IGMercier/Autonomous-Prospecting-and-Extraction-Systems-Controls/encoder_schematic.pdf

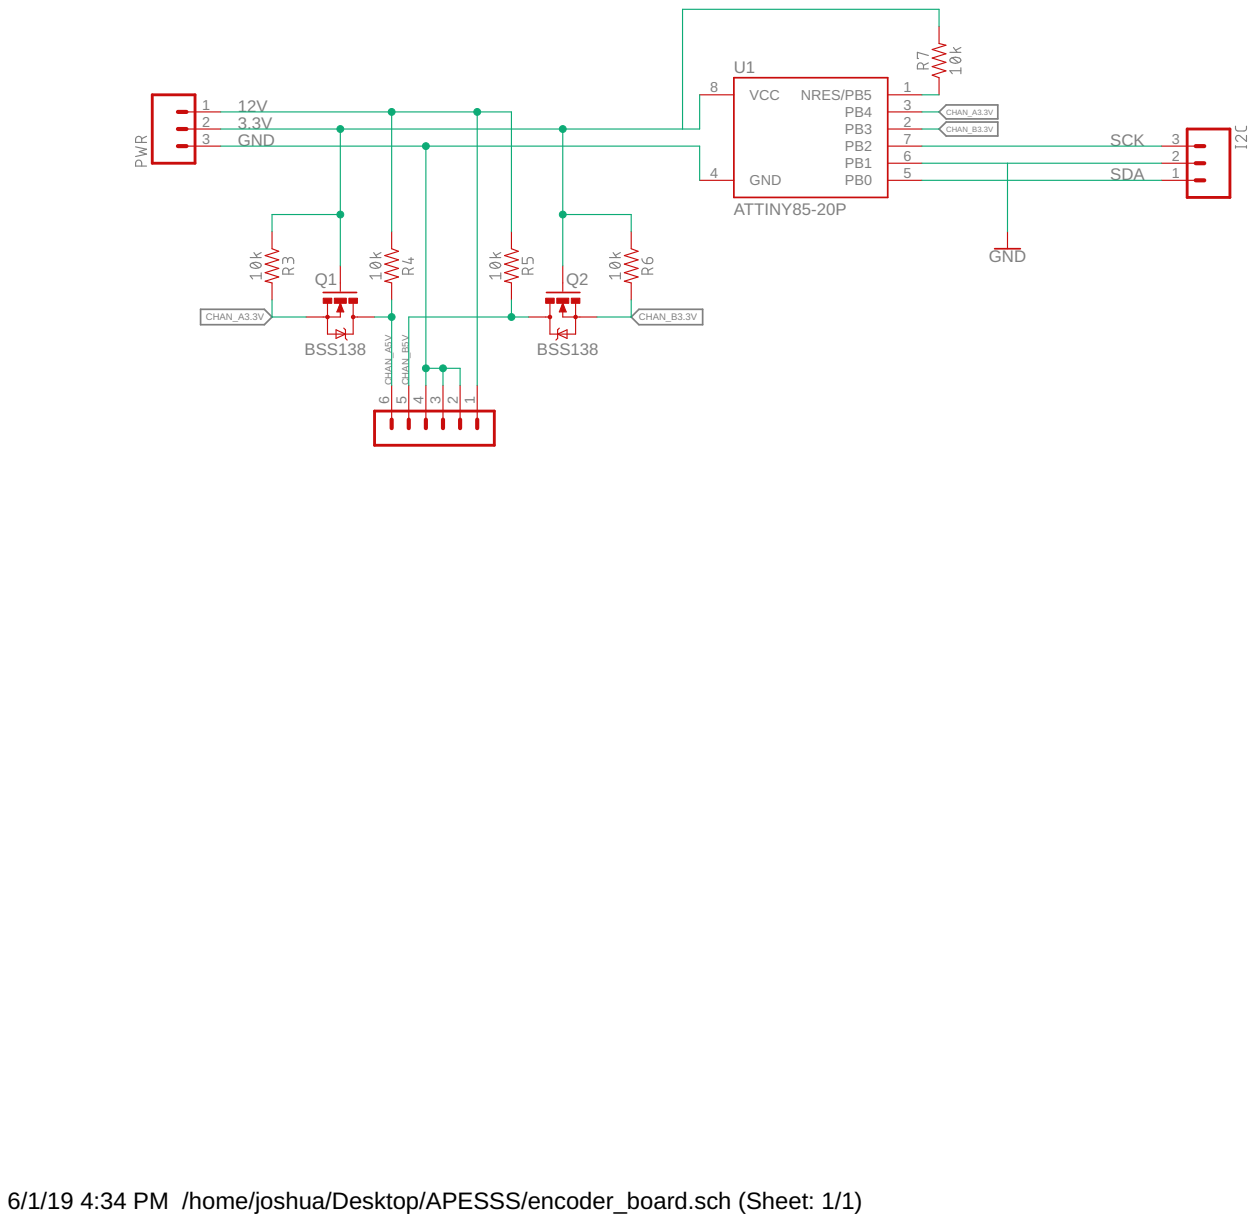
[picture p1: page 1]

6/1/19 4:34 PM /home/joshua/Desktop/APESSS/encoder_board.sch (Sheet: 1/1)
