IGMercier/Autonomous-Prospecting-and-Extraction-Systems-Controls/encoder_board.pdf

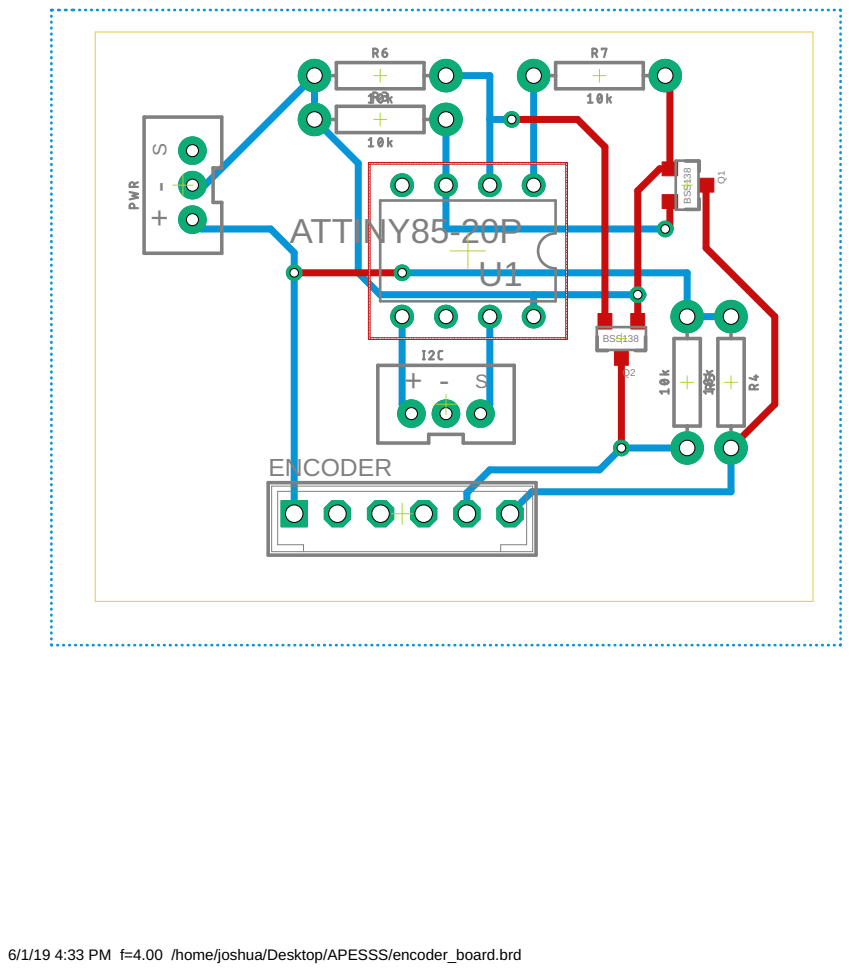
[picture p2: page 1]

6/1/19 4:33 PM f=4.00 /home/joshua/Desktop/APESSS/encoder_board.brd
