IGMercier/Autonomous-Prospecting-and-Extraction-Systems-Controls/single_board_controller.pdf

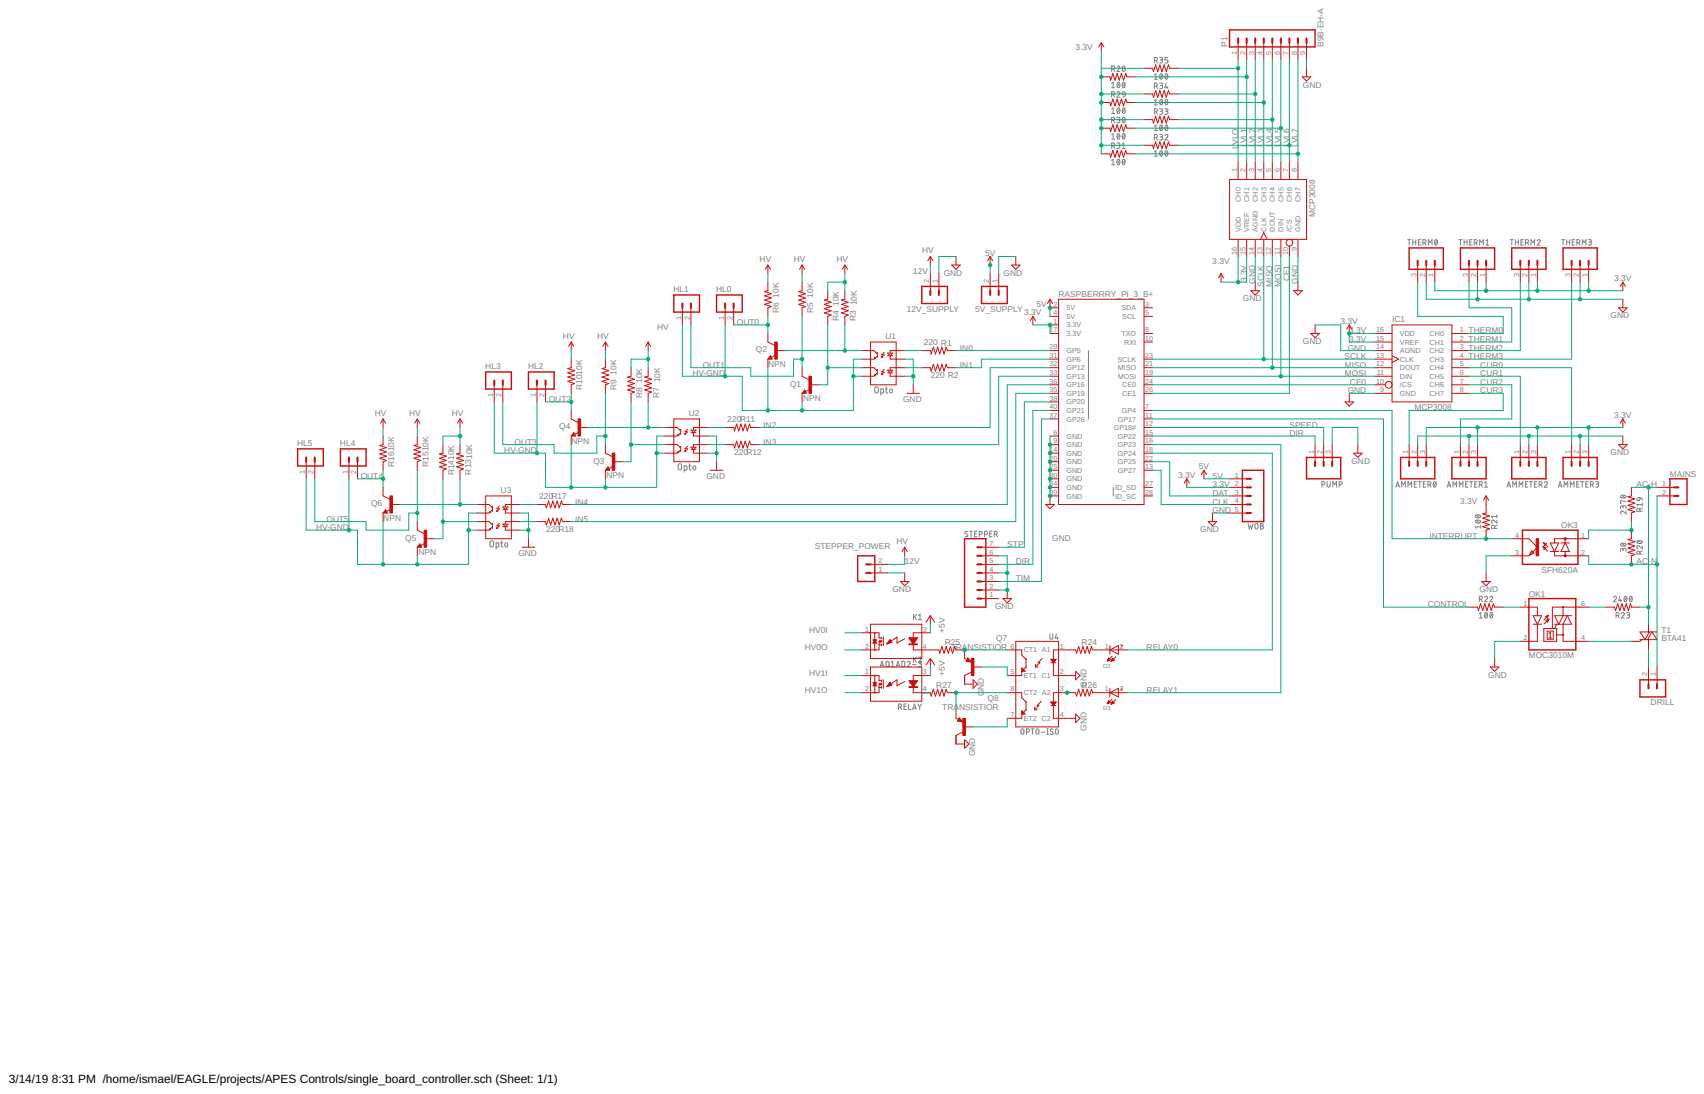
[picture p3: page 1]

24 | CE0 10 | 7 CH7 CUR2

GND 9 | CUR3

3/14/19 8:31 PM /home/ismael/EAGLE/projects/APES Controls/single_board_controller.sch (Sheet: 1/1)
