IGMercier/Autonomous-Prospecting-and-Extraction-Systems-Controls/drill_controller.pdf

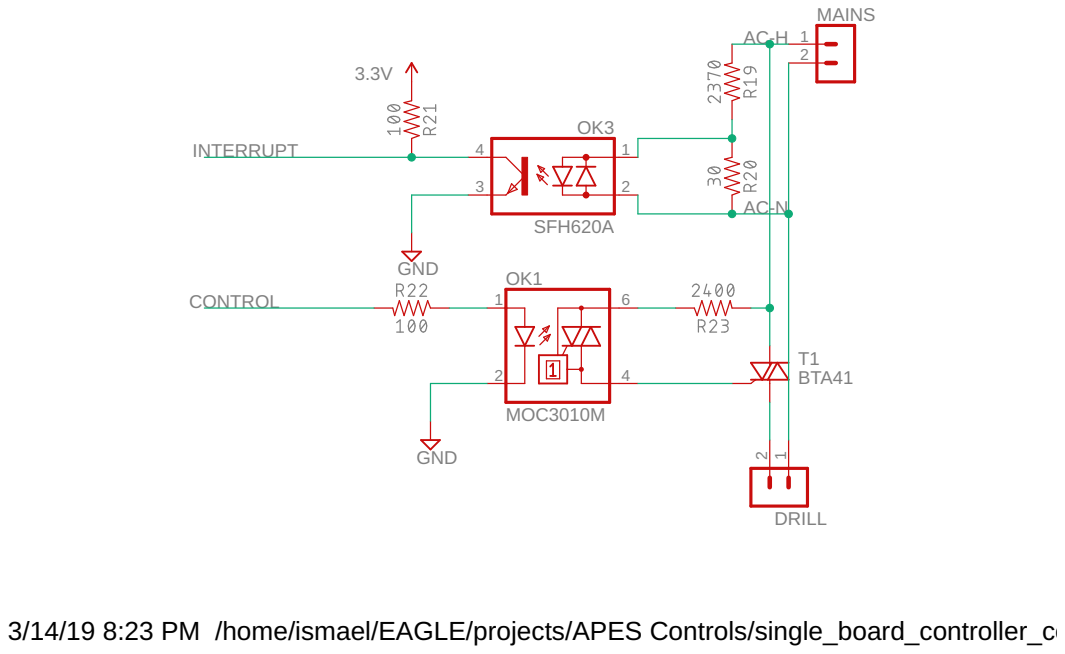
[picture p4: page 1]

3/14/19 8:23 PM /home/ismael/EAGLE/projects/APES Controls/single_board_controller_copy.sch (Sheet: 1/1)
