IGMercier/Autonomous-Prospecting-and-Extraction-Systems-Controls/heater_driver.pdf

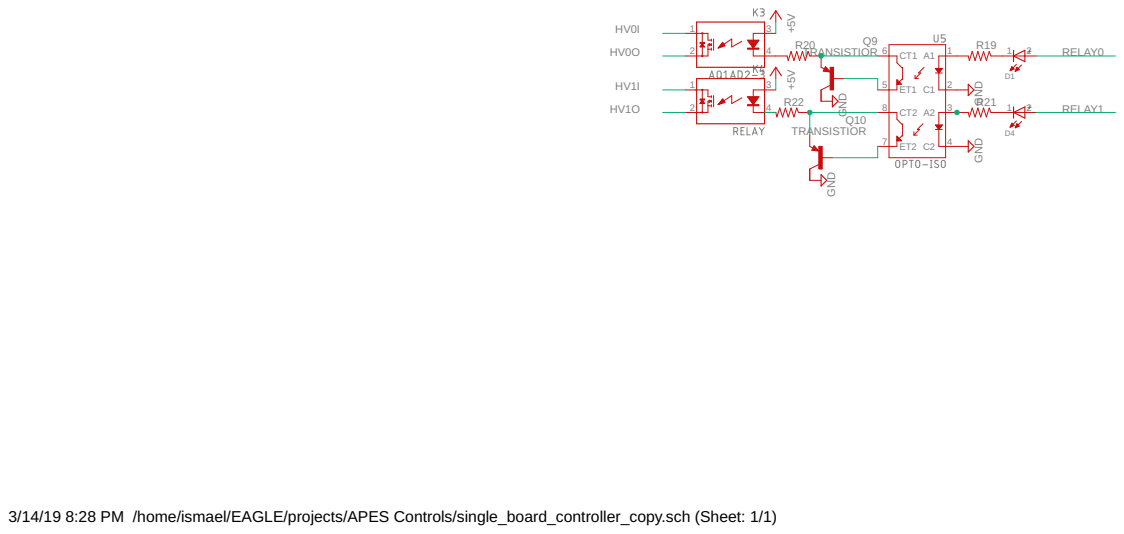
[picture p5: page 1]

3/14/19 8:28 PM /home/ismael/EAGLE/projects/APES Controls/single_board_controller_copy.sch (Sheet: 1/1)
