IGMercier/Autonomous-Prospecting-and-Extraction-Systems-Controls/temp_curr_sense.pdf

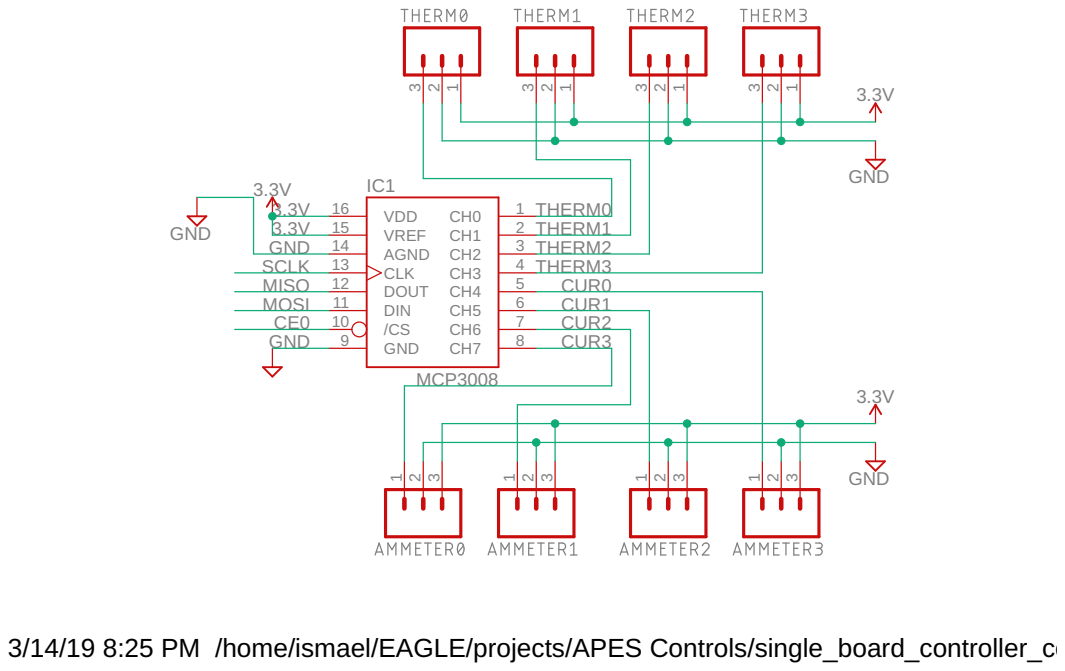
[picture p6: page 1]

3/14/19 8:25 PM /home/ismael/EAGLE/projects/APES Controls/single_board_controller_copy.sch (Sheet: 1/1)
