IGMercier/Autonomous-Prospecting-and-Extraction-Systems-Controls/valve_small_heater.pdf

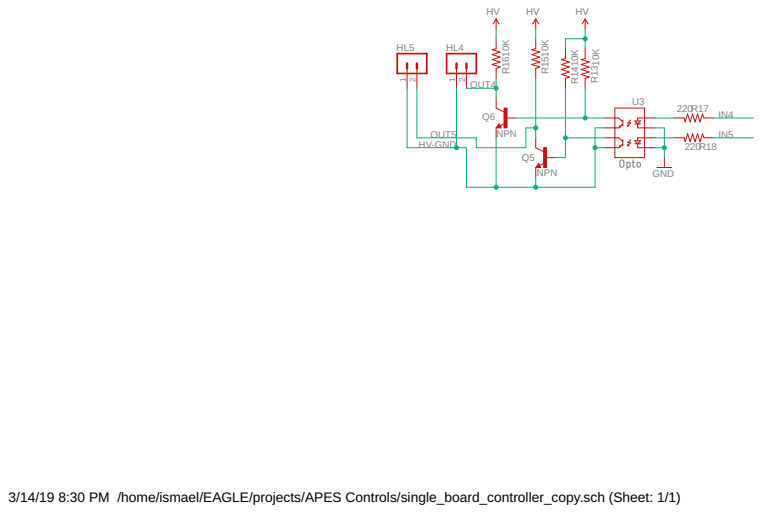
[picture p7: page 1]

3/14/19 8:30 PM /home/ismael/EAGLE/projects/APES Controls/single_board_controller_copy.sch (Sheet: 1/1)
