IGMercier/Autonomous-Prospecting-and-Extraction-Systems-Controls/water_level.pdf

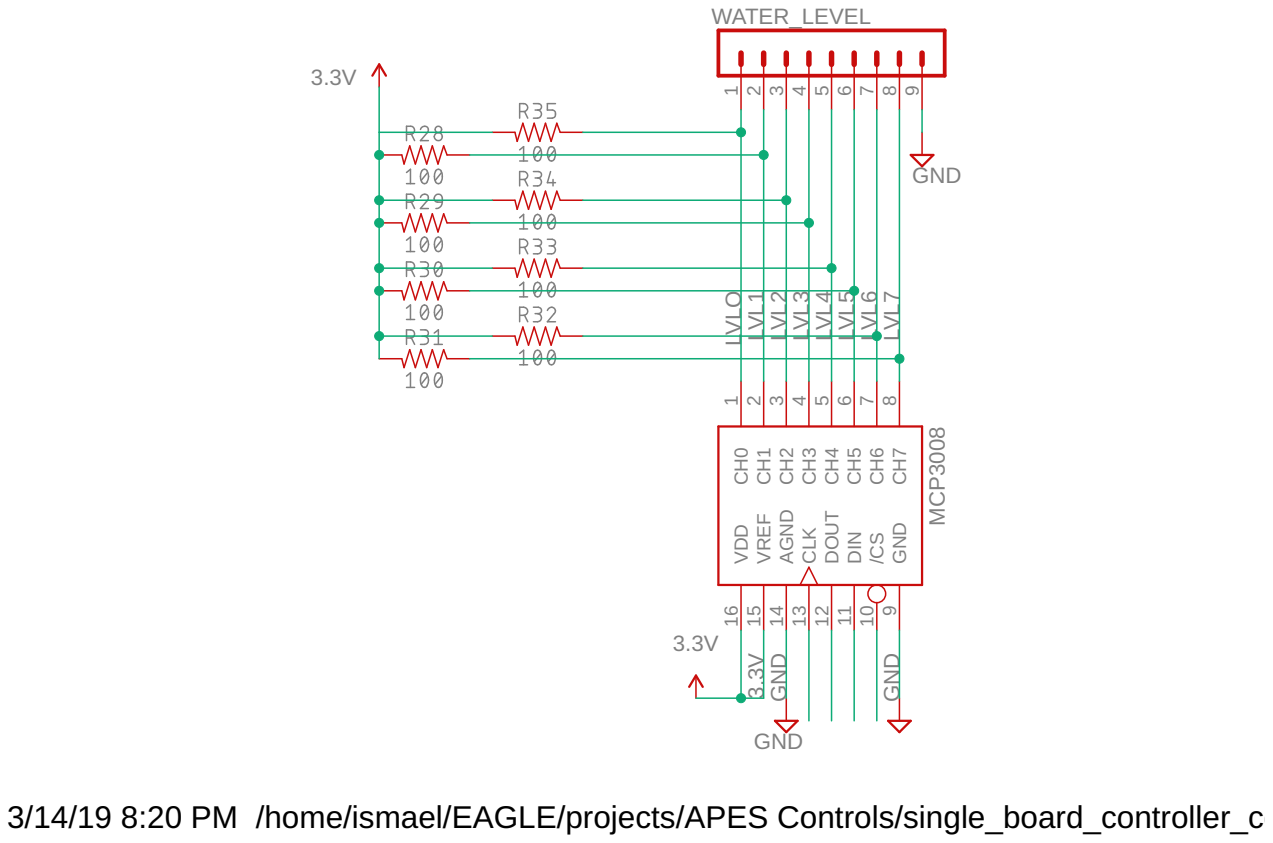
[picture p8: page 1]

3/14/19 8:20 PM /home/ismael/EAGLE/projects/APES Controls/single_board_controller_copy.sch (Sheet: 1/1)
