IGMercier/Autonomous-Prospecting-and-Extraction-Systems-Controls/single_board_controller.brd

## EAGLE design single_board_controller.brd (2019-06-02)

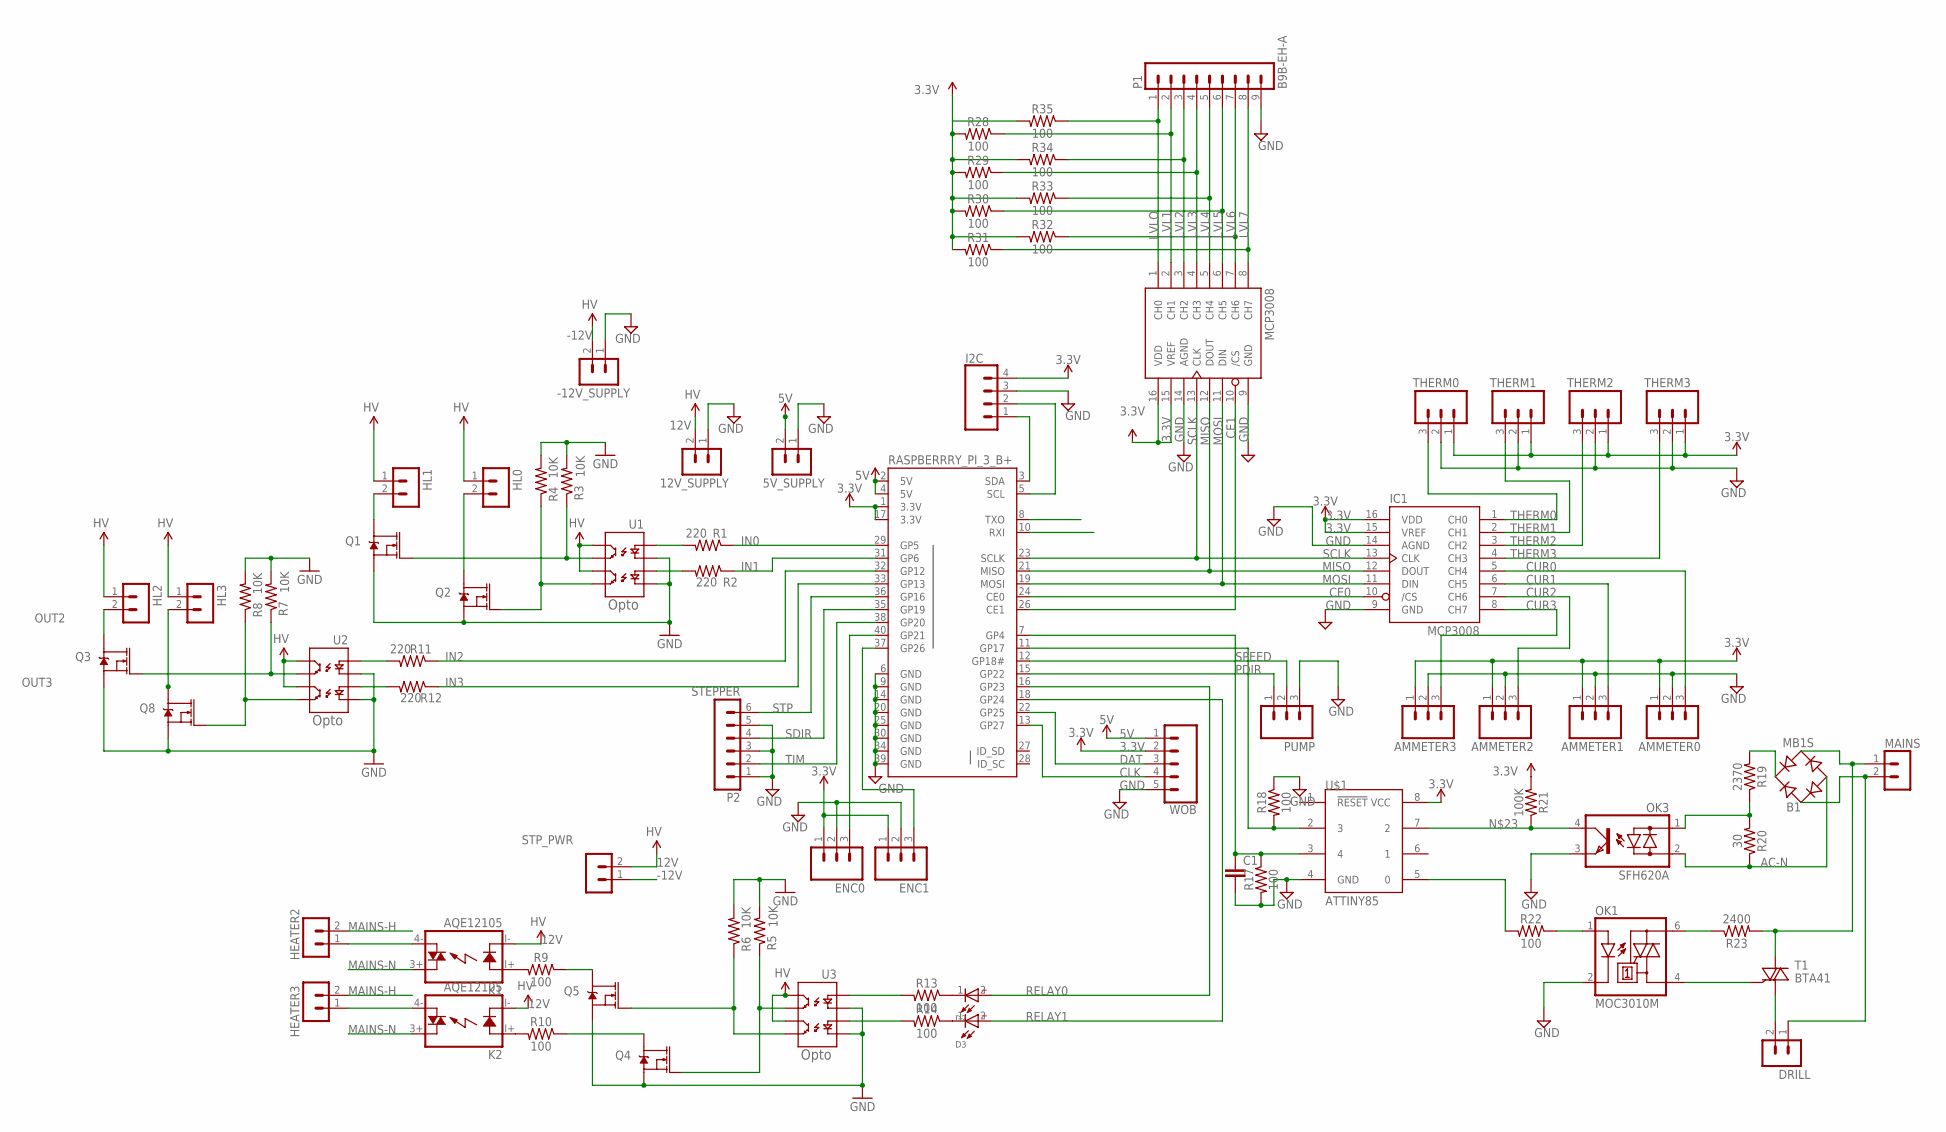
[picture p9: schematic single_board_controller.sch]

Parts:
5V_SUPPLY, 12V_SUPPLY: B2P-VH
-12V_SUPPLY: B2P-VH
AMMETER0, AMMETER1, AMMETER2, AMMETER3: CONN_03JST-PTH-VERT; JST-3-PTH-VERT
B1: MB1S; SOIC-4
C1: C; C0805
D2, D3: WL-SMRW_1206_156120YS75000-Y; WL-SMRW-1206-RECT
DRILL: B2P-VH
ENC0, ENC1: CONN_03JST-PTH-VERT; JST-3-PTH-VERT
HEATER2, HEATER3: B2P-VH
HL0, HL1, HL2, HL3: B2P-VH
I2C: CONN_04JST-PTH-VERT; JST-4-PTH-VERT
IC1, IC2: MCP3008; DIL16
K1, K2: AQE12105; AQE
MAINS: B2P-VH
OK1: MOC3010M; DIL06
OK3: SFH620A; DIL04
P1: B9B-EH-A
P2: STEPPER; B6B-EH-A
PUMP: CONN_03JST-PTH-VERT; JST-3-PTH-VERT
Q1, Q2, Q3, Q4, Q5, Q8: 35A/25V/8.5mΩ; DPAK
R1, R2, R11, R12: 220; 0603-RES
R3, R4, R5, R6, R7, R8: 10K; 0603-RES
R9, R10, R13, R14, R17, R18, R22, R28, R29, R30, R31, R32, R33, R34, R35: 100; 0805
R19: 2370; 0805
R20: 30; 0805
R21: 100K; 0805
R23: 2400; 0805
RASPBERRRY_PI_3_B+: RASPBERRYPI-40-PIN-GPIO_PTH_NO_SHROUD; 2X20
STP_PWR: B2P-VH
T1: BTA41; TOP3S-1
THERM0, THERM1, THERM2, THERM3: CONN_03JST-PTH-VERT; JST-3-PTH-VERT
U1, U2, U3: OPTOISOLATOR-2SOIC8; SO08-2
U$1: ATTINY85; 8P3
WOB: CONN_05JST-VERT; JST-5-PTH-VERT

Connections:
3.3V: AMMETER0.1, AMMETER1.1, AMMETER2.1, AMMETER3.1, ENC0.1, ENC1.1, I2C.4, IC1.15 (VREF), IC1.16 (VDD), IC2.15 (VREF), IC2.16 (VDD), R21.2, R28.2, R29.2, R30.2, R31.2, R32.2, R33.2, R34.2, R35.2, RASPBERRRY_PI_3_B+.1 (3.3V), RASPBERRRY_PI_3_B+.17 (3.3V), THERM0.1, THERM1.1, THERM2.1, THERM3.1, U$1.8 (VCC), WOB.2
5V: 5V_SUPPLY.2, RASPBERRRY_PI_3_B+.2 (5V), RASPBERRRY_PI_3_B+.4 (5V), WOB.1
12V: 12V_SUPPLY.2, HL0.1, HL1.1, HL2.1, HL3.1, K1.I- (K), K2.I- (K), STP_PWR.2, U1.6 (CL2), U1.8 (CL1), U2.6 (CL2), U2.8 (CL1), U3.6 (CL2), U3.8 (CL1)
-12V: -12V_SUPPLY.2, STP_PWR.1
AC-N: B1.-, OK3.2 (AC2), R20.1
CE0: IC1.10 (/CS), RASPBERRRY_PI_3_B+.24 (CE0)
CE1: IC2.10 (/CS), RASPBERRRY_PI_3_B+.26 (CE1)
CLK: RASPBERRRY_PI_3_B+.13 (GP27), WOB.4
CONTROL: R18.2, RASPBERRRY_PI_3_B+.11 (GP17), U$1.2 (3)
CUR0: AMMETER0.3, IC1.5 (CH4)
CUR1: AMMETER1.3, IC1.6 (CH5)
CUR2: AMMETER2.3, IC1.7 (CH6)
CUR3: AMMETER3.3, IC1.8 (CH7)
DAT: RASPBERRRY_PI_3_B+.22 (GP25), WOB.3
GND: 5V_SUPPLY.1, 12V_SUPPLY.1, -12V_SUPPLY.1, AMMETER0.2, AMMETER1.2, AMMETER2.2, AMMETER3.2, C1.2, ENC0.2, ENC1.2, I2C.3, IC1.9 (GND), IC1.14 (AGND), IC2.9 (GND), IC2.14 (AGND), OK1.2 (C), OK3.3 (E), P1.9, P2.1, P2.3, P2.5, PUMP.3, Q1.3 (S), Q2.3 (S), Q3.3 (S), Q4.3 (S), Q5.3 (S), Q8.3 (S), R3.2, R4.2, R5.2, R6.2, R7.2, R8.2, R17.2, R18.1, RASPBERRRY_PI_3_B+.6 (GND), RASPBERRRY_PI_3_B+.9 (GND), RASPBERRRY_PI_3_B+.14 (GND), RASPBERRRY_PI_3_B+.20 (GND), RASPBERRRY_PI_3_B+.25 (GND), RASPBERRRY_PI_3_B+.30 (GND), RASPBERRRY_PI_3_B+.34 (GND), RASPBERRRY_PI_3_B+.39 (GND), THERM0.2, THERM1.2, THERM2.2, THERM3.2, U1.2 (C1), U1.4 (C2), U2.2 (C1), U2.4 (C2), U3.2 (C1), U3.4 (C2), U$1.4 (GND), WOB.5
IN0: R1.1, RASPBERRRY_PI_3_B+.29 (GP5)
IN1: R2.1, RASPBERRRY_PI_3_B+.31 (GP6)
IN2: R11.1, RASPBERRRY_PI_3_B+.32 (GP12)
IN3: R12.1, RASPBERRRY_PI_3_B+.33 (GP13)
LVL1: IC2.2 (CH1), P1.2, R28.1
LVL2: IC2.3 (CH2), P1.3, R34.1
LVL3: IC2.4 (CH3), P1.4, R29.1
LVL4: IC2.5 (CH4), P1.5, R33.1
LVL5: IC2.6 (CH5), P1.6, R30.1
LVL6: IC2.7 (CH6), P1.7, R32.1
LVL7: IC2.8 (CH7), P1.8, R31.1
LVLO: IC2.1 (CH0), P1.1, R35.1
MAINS-H: B1.~2 (AC2), HEATER2.2, HEATER3.2, MAINS.1, R23.2, T1.A2
MAINS-N: B1.~1 (AC1), DRILL.1, K1.3+ (DS1), K2.3+ (DS1), MAINS.2
MISO: IC1.12 (DOUT), IC2.12 (DOUT), RASPBERRRY_PI_3_B+.21 (MISO)
MOSI: IC1.11 (DIN), IC2.11 (DIN), RASPBERRRY_PI_3_B+.19 (MOSI)
unnamed: R1.2, U1.1 (A1)
unnamed: R2.2, U1.3 (A2)
unnamed: R11.2, U2.1 (A1)
unnamed: R12.2, U2.3 (A2)
unnamed: ENC1.3, RASPBERRRY_PI_3_B+.37 (GP26)
unnamed: ENC0.3, RASPBERRRY_PI_3_B+.40 (GP21)
unnamed: OK3.1 (AC1), R19.1, R20.2
unnamed: OK1.1 (A), R22.1
unnamed: OK1.6 (A2), R23.1
unnamed: OK1.4 (A1), T1.G
unnamed: DRILL.2, T1.A1
unnamed: HEATER2.1, K1.4- (DS2)
unnamed: D2.1 (-), R13.1
unnamed: K2.I+ (A), R10.2
unnamed: D3.1 (-), R14.1
unnamed: K1.I+ (A), R9.2
unnamed: HEATER3.1, K2.4- (DS2)
unnamed: R13.2, U3.1 (A1)
unnamed: OK3.4 (C), R21.1, U$1.7 (2)
unnamed: B1.+, R19.2
unnamed: R22.2, U$1.5 (0)
unnamed: I2C.2, RASPBERRRY_PI_3_B+.5 (SCL)
unnamed: C1.1, R17.1, RASPBERRRY_PI_3_B+.7 (GP4), U$1.3 (4)
unnamed: I2C.1, RASPBERRRY_PI_3_B+.3 (SDA)
unnamed: R14.2, U3.3 (A2)
unnamed: Q5.4 (D), R9.1
unnamed: Q4.4 (D), R10.1
OUT0: HL1.2, Q1.4 (D)
OUT1: HL0.2, Q2.4 (D)
OUT1N: Q1.1 (G), R3.1, U1.7 (EM1)
OUT1N1: Q3.1 (G), R7.1, U2.7 (EM1)
OUT1N2: Q4.1 (G), R5.1, U3.7 (EM1)
OUT2: HL2.2, Q3.4 (D)
OUT2N: Q2.1 (G), R4.1, U1.5 (EM2)
OUT2N1: Q8.1 (G), R8.1, U2.5 (EM2)
OUT2N2: Q5.1 (G), R6.1, U3.5 (EM2)
OUT3: HL3.2, Q8.4 (D)
PDIR: PUMP.1, RASPBERRRY_PI_3_B+.15 (GP22)
RELAY0: D2.2 (+), RASPBERRRY_PI_3_B+.16 (GP23)
RELAY1: D3.2 (+), RASPBERRRY_PI_3_B+.18 (GP24)
SCLK: IC1.13 (CLK), IC2.13 (CLK), RASPBERRRY_PI_3_B+.23 (SCLK)
SDIR: P2.4, RASPBERRRY_PI_3_B+.35 (GP19)
SPEED: PUMP.2, RASPBERRRY_PI_3_B+.12 (GP18#)
STP: P2.6, RASPBERRRY_PI_3_B+.36 (GP16)
THERM0: IC1.1 (CH0), THERM0.3
THERM1: IC1.2 (CH1), THERM1.3
THERM2: IC1.3 (CH2), THERM2.3
THERM3: IC1.4 (CH3), THERM3.3
TIM: P2.2, RASPBERRRY_PI_3_B+.38 (GP20)

Notes on the sheet:
Opto

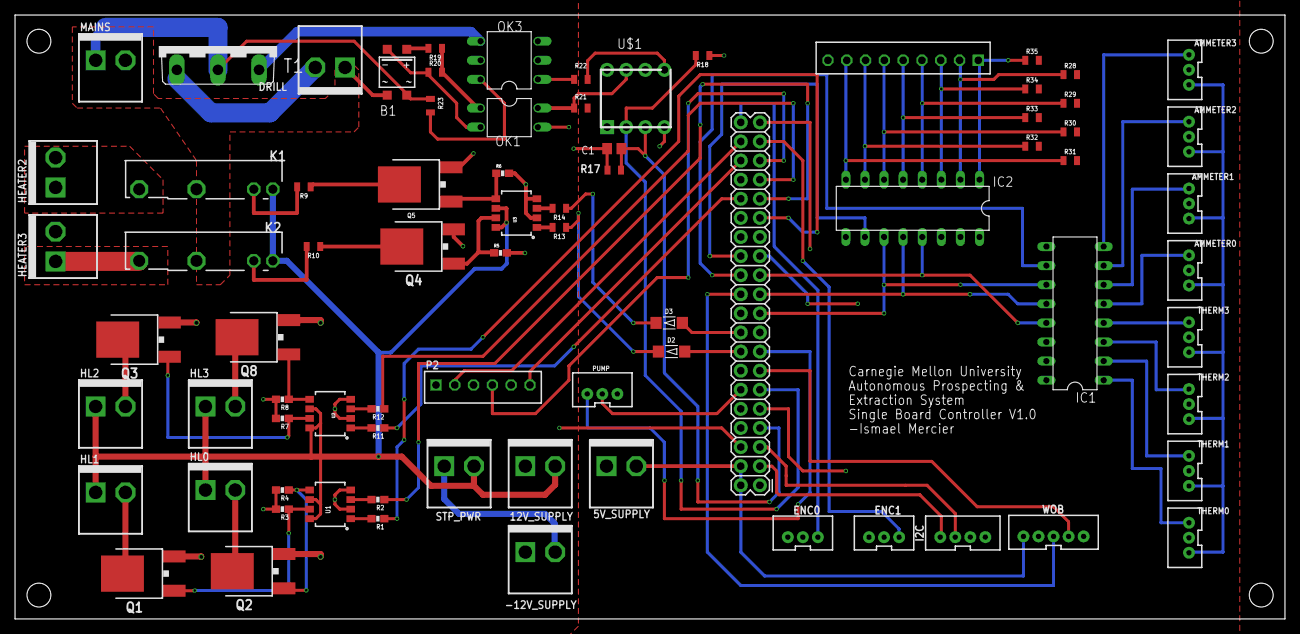
[picture p10: board single_board_controller.brd from above]

Board: 2 copper layers, 168.9 x 80.3 mm, 78 parts (0 on the bottom side), 80 nets.
