IGMercier/Autonomous-Prospecting-and-Extraction-Systems-Controls/encoder_board.brd

## EAGLE design encoder_board.brd (2019-04-23)

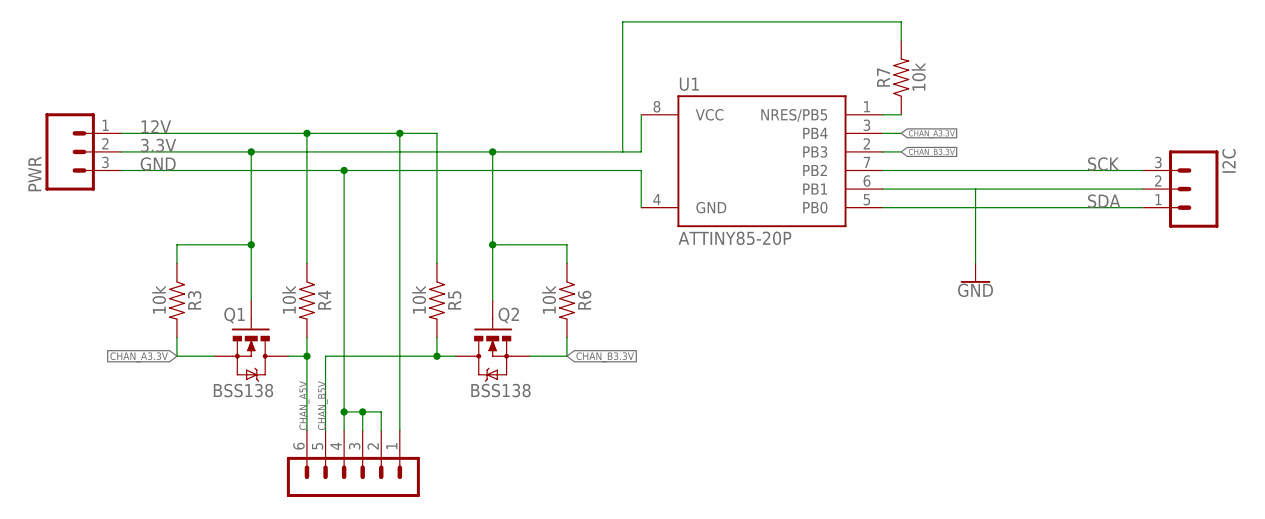
[picture p11: schematic encoder_board.sch]

Parts:
ENCODER: B6B-EH-A
I2C: CONN_03JST-PTH-VERT; JST-3-PTH-VERT
PWR: CONN_03JST-PTH-VERT; JST-3-PTH-VERT
Q1, Q2: BSS138; SOT23-3
R3, R4, R5, R6, R7: 10k; AXIAL-0.3
U1: ATTINY85-20P; PDIP08_300MIL

Connections:
3.3V: PWR.2, Q1.1 (G), Q2.1 (G), R3.P$1 (1), R6.P$1 (1), R7.P$2 (2), U1.8 (VCC)
12V: ENCODER.1, PWR.1, R4.P$1 (1), R5.P$1 (1)
CHAN_A3.3V: Q1.2 (S), R3.P$2 (2), U1.3 (PB4)
CHAN_A5V: ENCODER.6, Q1.3 (D), R4.P$2 (2)
CHAN_B3.3V: Q2.2 (S), R6.P$2 (2), U1.2 (PB3)
CHAN_B5V: ENCODER.5, Q2.3 (D), R5.P$2 (2)
GND: ENCODER.2, ENCODER.3, ENCODER.4, I2C.2, PWR.3, U1.4 (GND), U1.6 (PB1)
unnamed: R7.P$1 (1), U1.1 (NRES/PB5)
SCK: I2C.3, U1.7 (PB2)
SDA: I2C.1, U1.5 (PB0)

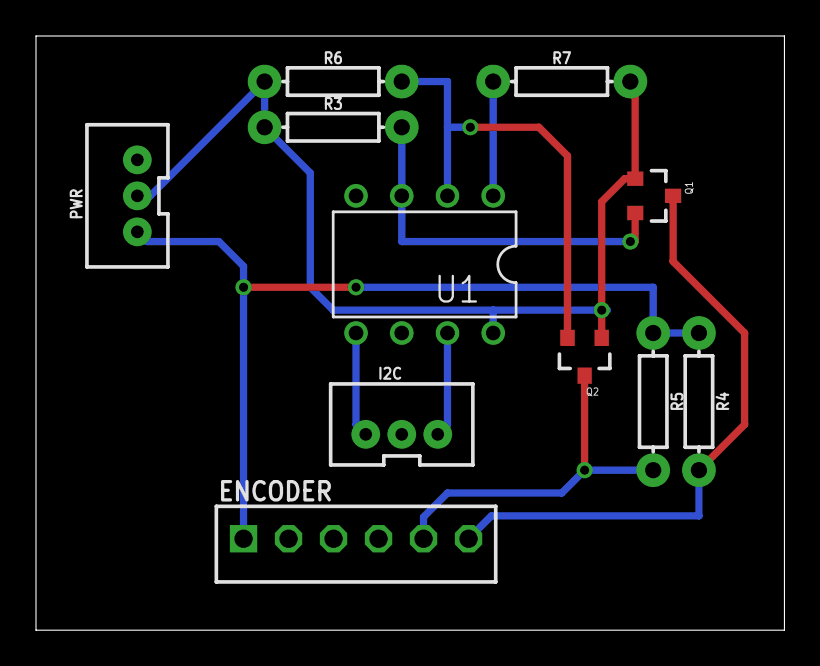
[picture p12: board encoder_board.brd from above]

Board: 2 copper layers, 41.6 x 33.0 mm, 11 parts (0 on the bottom side), 10 nets.
