IGMercier/Autonomous-Prospecting-and-Extraction-Systems-Controls/src/shell/shell.cpp

#include <thread>
#include <cstring>
#include <cstdlib>
#include <cstdio>
#include <unistd.h>

#include "shell.h"
#include "usr_defined.h" // thread_arg, execute
//#include "../misc/flags.h"
//#include "../misc/flags_set.h"
#include "../misc/rio.h"

#define MAXLINE 1024
#define MAXARGS 128

int shutdownSIG = 0; // remove after testing!!!

using std::thread;

Shell::Shell() {}
Shell::~Shell() {}

void Shell::run(int *shell_cfd) {
    char cmdline[MAXLINE];

    rio_t buf;
    rio_readinitb(&buf, STDIN_FILENO);

    while (!shutdownSIG) {
        rio_readlineb(&buf, cmdline, MAXLINE);
        if (feof(stdin)) {
            printf("\n");
            fflush(stdout);
            fflush(stdin);
        }

        evaluate(cmdline);
    }
    return; // kills shell thread in main program
}

void Shell::evaluate(char *cmdline) {
    char *argv[MAXARGS];
    char buf[MAXLINE];
    int bg;
    thread child;

    strcpy(buf, cmdline);
    bg = parseline(buf, argv);

    if (argv[0] == NULL) {
        return;
    }

    if (!command(argv)) {
        /* CHILD THREAD */
        thread_arg arg;
        arg.argv = argv;
        arg.bg = bg;
        arg.len = MAXLINE;
        thread temp(execute, &arg);
        child.swap(temp);

        if (bg) {
            child.detach();
        }
    }

    /* PARENT THREAD */
    if (!bg) {
        if (child.joinable()) { // safeguard against <builtin> &
            // wait for child thread to end
            child.join();
        }
    }

    return;
}

int Shell::command(char **argv) {
    if (!strcmp(argv[0], "quit")) {
        exit(0);
    }
    if (!strcmp(argv[0], "&")) {
        return 1;
    }

    return 0;

}

int Shell::parseline(char *buf, char **argv) {
    char *delim;
    int argc;
    int bg;

    buf[strlen(buf)-1] = ' ';

    while (*buf && (*buf == ' ')) { buf++; }

    argc = 0;
    while ((delim = strchr(buf, ' '))) {
        argv[argc++] = buf;
        *delim = '\0';
        buf = delim + 1;
        while (*buf && (*buf == ' ')) { buf++; }
    }

    argv[argc] = NULL;

    if (argc == 0) { return 1; }

    if ((bg = (*argv[argc-1] == '&')) != 0) {
        argv[--argc] = NULL;
    }


    return bg;
}
