IGMercier/Autonomous-Prospecting-and-Extraction-Systems-Controls/src/rio.cpp

#include "helper.h"
#include <cstring>
#include <errno.h>


/*
    NEWTORK-SAFE FILE READ/WRITE (BUFFERED)
    from Computer Systems by Bryant & O'Hallaron
*/
static ssize_t rio_read(rio_t *rp, char *usrbuf, size_t n);

ssize_t rio_readn(int fd, void *usrbuf, size_t n) {
    size_t nleft = n;
    ssize_t nread;
    char *bufp = (char *)usrbuf;

    while (nleft > 0) {
        if ((nread = read(fd, bufp, nleft)) < 0) {
            if (errno != EINTR) {
                return -1;  /* errno set by read() */
            }

            /* Interrupted by sig handler return, call read() again */
            nread = 0;
        } else if (nread == 0) {
            break;                  /* EOF */
        }
        nleft -= nread;
        bufp += nread;
    }
    return n - nleft;             /* Return >= 0 */
}

ssize_t rio_writen(int fd, void *usrbuf, size_t n) {
    size_t nleft = n;
    ssize_t nwritten;
    char *bufp = (char *)usrbuf;

    while (nleft > 0) {
        if ((nwritten = write(fd, bufp, nleft)) <= 0) {
            if (errno != EINTR) {
                return -1;       /* errno set by write() */
            }

            /* Interrupted by sig handler return, call write() again */
            nwritten = 0;
        }
        nleft -= nwritten;
        bufp += nwritten;
    }
    return n;
}

static ssize_t rio_read(rio_t *rp, char *usrbuf, size_t n) {
    int cnt;

    while (rp->rio_cnt <= 0) {      /* Refill if buf is empty */
        rp->rio_cnt = read(rp->rio_fd, rp->rio_buf, sizeof(rp->rio_buf));
        if (rp->rio_cnt < 0) {
            if (errno != EINTR) {
                return -1;          /* errno set by read() */
            }

            /* Interrupted by sig handler return, nothing to do */
        } else if (rp->rio_cnt == 0) {
            return 0;               /* EOF */
        } else {
            rp->rio_bufptr = rp->rio_buf;   /* Reset buffer ptr */
        }

    /* Copy min(n, rp->rio_cnt) bytes from internal buf to user buf */
    cnt = n;
    if ((size_t) rp->rio_cnt < n) {
        cnt = rp->rio_cnt;
    }
    memcpy(usrbuf, rp->rio_bufptr, cnt);
    rp->rio_bufptr += cnt;
    rp->rio_cnt -= cnt;
    return cnt;
}

void rio_readinitb(rio_t *rp, int fd) {
    rp->rio_fd = fd;
    rp->rio_cnt = 0;
    rp->rio_bufptr = rp->rio_buf;
}

ssize_t rio_readnb(rio_t *rp, void *usrbuf, size_t n) {
    size_t nleft = n;
    ssize_t nread;
    char *bufp = (char *)usrbuf;

    while (nleft > 0) {
        if ((nread = rio_read(rp, bufp, nleft)) < 0) {
            return -1;          /* errno set by read() */
        } else if (nread == 0) {
            break;              /* EOF */
        }
        nleft -= nread;
        bufp += nread;
    }
    return (n - nleft);         /* return >= 0 */
}

ssize_t rio_readlineb(rio_t *rp, void *usrbuf, size_t maxlen) {
    size_t n;
    int rc;
    char c, *bufp = (char *)usrbuf;

    for (n = 1; n < maxlen; n++) {
        if ((rc = rio_read(rp, &c, 1)) == 1) {
            *bufp++ = c;
            if (c == '\n') {
                n++;
                break;
            }
        } else if (rc == 0) {
            if (n == 1) {
                return 0; /* EOF, no data read */
            } else {
                break;    /* EOF, some data was read */
            }
        } else {
            return -1;    /* Error */
        }
    }
    *bufp = 0;
    return n-1;
}
