IGMercier/Autonomous-Prospecting-and-Extraction-Systems-Controls/src/shell/shellBase.cpp

#include <cstdlib>
#include <cstring>
#include <cstdio>
#include <unistd.h>
#include <thread>
#include <assert.h>
#include <sstream>
#include "shellBase.h"
#include "../misc/flags.h"


static void execute(parse_token *tk, int bg);

using std::thread;
ShellBase::ShellBase() {}
ShellBase::~ShellBase() {}

void ShellBase::run() {
    char buf[MAXLINE];
    
    while (1) {
        read(STDIN_FILENO, buf, MAXLINE);

        if (feof(stdin)) {
            printf("\n");
            fflush(stdout);
            fflush(stdin);
        }
        std::string cmdline(buf);
        evaluate(cmdline);
    }
    return; // kills shell thread in main program
}

void ShellBase::evaluate(std::string cmdline) {
    int bg;
    parse_token tk;
    thread child;

    bg = parseline(cmdline, &tk);

    if (tk.argc == 0) {
        return;
    }

    if (!builtin_command(&tk)) {
        /* CHILD THREAD */
        thread temp(execute, &tk, bg);
        child.swap(temp);

        if (bg) {
            child.detach();
        }
    }

    /* PARENT THREAD */
    if (!bg) {
        if (child.joinable()) { // safeguard against <builtin> &
            // wait for child thread to end
            child.join();
        }
    }

    return;
}

// returns 1 if a builtin, 0 otherwise
int ShellBase::builtin_command(parse_token *tk) {
    assert(tk != NULL);

    builtin bcomm = tk->bcomm;

    switch(bcomm) {
        case BUILTIN_FG:
            return 1;
        case BUILTIN_BG:
            return 1;
        case BUILTIN_JOBS:
            return 1;
        case BUILTIN_NONE:
        default:
            return 0;
    }
}

int ShellBase::parseline(std::string cmdline, parse_token *tk) {
    std::istringstream f(cmdline);
    std::string argv;
    int bg;

    int argc = 0;

    while (getline(f, argv, ' ')) {

        tk->argv[argc] = argv;
        argc++;
        if (argc == MAXARGS) { break; } 
    }

    tk->argc = argc;

    if (tk->argc == 0) {
        return 1;
    }

    
    if (tk->argv[0] == "fg") {
        tk->bcomm = BUILTIN_FG;
    } else if (tk->argv[0] == "bg") {
        tk->bcomm = BUILTIN_BG;
    } else if (tk->argv[0] == "jobs") {
        tk->bcomm = BUILTIN_JOBS;
    } else {
        tk->bcomm = BUILTIN_NONE;
    }


    if ((bg = (tk->argv[tk->argc-1] == "&")) != 0) {
        tk->argv[--(tk->argc)] = "";
    }

    tk->bg = bg;

    return bg;
}

void ShellBase::print(std::string msg) {
    std::string toPrint = "Shell: " + msg;
    printf("%s\n", msg.c_str());
    return;
}

static void execute(parse_token *tk, int bg) {
    assert(tk != NULL);
    fprintf(stdout, "IN THREAD\n");

    if (bg) {
        fprintf(stdout, "\t\t\tA BG JOB\n");
    }

    for (int i = 0; i < tk->argc; i++) {
        if (tk->argv[i].empty()) { break; }
        fprintf(stdout, "%s ", tk->argv[i].c_str());
    }

    if (bg) {
        fprintf(stdout, "\n");
        
        fflush(stdout);
        
    }
    return;
}
