IGMercier/Autonomous-Prospecting-and-Extraction-Systems-Controls/src/commands.cpp

#include "commands.h"
#include <cstring>

int parseline(const char *cmdline, token *tk) {
    const char delims[] = " \t\r\n";
    char *buf;
    char *next;
    char *endbuf;

    if (cmdline == NULL) {
        return -1;
    }

    strncpy(tk->text, cmdline, MAXLINE);

    buf = tk->text;
    endbuf = tk->text + strlen(tk->text);

    tk->argc = 0;

    while (buf < endbuf) {
        buf += strspn(buf, delims); // skips by num of delimiters
        if (buf >= endbuf) { break; }

        next = buf + strcspn(buf, delims);

        *next = '\0'; // make buf into valid c string

        tk->argv[tk->argc] = buf;
        tk->argc = tk->argc + 1;

        if (tk->argc >= MAXARGS - 1) { break; }

        buf = next + 1;
    }

    tk->argv[tk->argc] = NULL;
    if (tk->argc == 0) { return -1; }

    if ((strcmp(tk->argv[0], "quit")) == 0) {
        tk->command = QUIT;
    } else if ((strcmp(tk->argv[0], "start")) == 0) {
        tk->command = START;
    } else if ((strcmp(tk->argv[0], "standby")) == 0) {
        tk->command = STANDBY;
    } else if ((strcmp(tk->argv[0], "temp")) == 0) {
        tk->command = TEMP;
    } else if ((strcmp(tk->argv[0], "dtemp")) == 0) {
        tk->command = DTEMP;
    } else if ((strcmp(tk->argv[0], "curr")) == 0) {
        tk->command = CURR;
    } else if ((strcmp(tk->argv[0], "level")) == 0) {
        tk->command = WLEVEL;
    } else if ((strcmp(tk->argv[0], "wob")) == 0) {
        tk->command = WOB;
    } else if ((strcmp(tk->argv[0], "motor_drive")) == 0) {
        tk->command = MOTOR_DRIVE;
    } else if ((strcmp(tk->argv[0], "motor_stop")) == 0) {
        tk->command = MOTOR_STOP;
    } else if ((strcmp(tk->argv[0], "drill_run")) == 0) {
        tk->command = DRILL_RUN;
    } else if ((strcmp(tk->argv[0], "drill_stop")) == 0) {
        tk->command = DRILL_STOP;
    } else if ((strcmp(tk->argv[0], "drill_cycle")) == 0) {
        tk->command = DRILL_CYCLE;
    } else if ((strcmp(tk->argv[0], "auto")) == 0) {
        tk->command = AUTO;
    } else if ((strcmp(tk->argv[0], "help")) == 0) {
        tk->command = HELP;
    } else {
        tk->command = NONE;
    }

    return 0;
}
