IGMercier/Autonomous-Prospecting-and-Extraction-Systems-Controls/(commit log)

2019-01-20 Add files via upload
    initial commit
    [ADB.sch, stepstick.brd, stepstick.sch]
2019-01-20 added new design blocks, started Sensor board and outlined the missing parts
    [SB.sch]
2019-01-26 Update MAX31856_thermocouple.dbl
    Added a voltage regulator because the sensor takes in 3.3V but our system is on 5V
2019-01-26 Uploaded MPR_pressure.dbl
    Breakout schematic for the temp barometric sensor (datasheet :https://sensing.honeywell.com/MPRLS0025PA00001A-amplified-board-mount-pressure-sensors), can be configured with I2C or SPI hardware
2019-03-19 new Single Board Driver
    [single_board_controller.brd, single_board_controller.sch, single_board_controller_copy.sch, triac.sch]
2019-03-19 placed the WOB header on brd, changed valve driver to two encoder headers, placed them on the brd
    [single_board_controller.brd, single_board_controller.sch]
2019-03-20 begun placing high power connectors
    [single_board_controller.brd]
2019-03-20 began adding 12V driver
    [single_board_controller.brd, single_board_controller.sch]
2019-03-21 began cleaning up stencils
    [single_board_controller.brd, single_board_controller.sch]
2019-03-21 added atiny85 drill driver, added mounting holes, isolated ground and 3.3V planes from AC, added I2C connector, still need to choose new mosfets, still need to verify AC circuitry, still need to pick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
    [single_board_controller.brd, single_board_controller.sch]
2019-03-23 in process of replacing components
    [single_board_controller.brd, single_board_controller.sch]
2019-03-30 already sent to fab, working on small improvements
    [single_board_controller.brd, single_board_controller.sch]
2019-03-31 removed time and spi members from APE class
2019-04-01 first draft encoder board schematic
    [encoder_board.sch]
2019-04-01 fixed huge bug: python interpreter exited after setup. @TODO: i need to provide better documentation...
    [APES.cpp, APES.h]
2019-04-04 updated encoder board schematic
2019-04-04 created encoder board
    [encoder_board.brd]
2019-04-06 updated encoder_board sch
    [encoder_board.sch]
2019-04-06 updated headers in encoder_board sch
    [encoder_board.sch]
2019-04-14 added wiringPi initializer
2019-05-16 added printouts for manual readings
2019-05-16 added motor methods to main system class
2019-05-16 added motor func in server file
2019-05-16 implemented parseline, needs to be fixed
    [APES.cpp, APES.h, commands.cpp, commands.h]
2019-05-18 reimplemented server/client functions, still getting a large bug where commands aren't being interpreted correctly
    [commands.cpp, commands.h]
2019-05-19 fixed server bug, commands are recognized
    [commands.cpp, commands.h]
2019-05-19 finally fixed the disconnect issue
    [commands.cpp, commands.h]
2019-05-20 added time func to Motor method
2019-05-21 put in threads for each sensor, I will need to refactor the whole server.cpp to designate foreground and background jobs :[
2019-05-21 prints connected ip address
2019-05-21 fixed the segfault bug :]
    [program.cpp]
2019-05-22 fixed the TCP bug, but will haveto do heavier testing just in case
    [program.cpp]
2019-05-23 switched to c++ threads
2019-05-23 in the middle of integrating, deleted commented out code, need to figure out how to stop the server thread
2019-05-23 added condition to kill server and shell threads
2019-05-23 finally fixed parsing bug
    [commands.cpp, commands.h, program.cpp, shellBase.cpp, shellBase.h]
2019-05-24 fixed some headers in shell and server
    [APESShell.cpp, shellBase.cpp, shellBase.h]
2019-05-24 ugh i have a tcp buggg
    [commands.h, serverTest.cpp]
2019-05-24 removed client-thread bc that was unnecessary...
2019-05-25 inserted write to cmd.txt
2019-05-26 debugging stack smashing error
    [program.cpp]
2019-05-28 added ServerBase::print
2019-05-28 implemented funcs to simulataneously read sensor data
2019-05-29 started implementation of Encoder class
2019-05-30 fixed how data was printed to file
    [APES.cpp]
2019-05-30 made a sad-looking test and fixed program bug
    [program.cpp, serverTest.cpp]
2019-05-30 added help msg, it doesn't work tho
    [APES.cpp, APES.h, APESShell.cpp, shellBase.cpp, shellBase.h]
2019-05-31 added motor_x and motor_y
2019-05-31 Ensured socket read thread will join
2019-06-01 final pcb and schematic for Single board controller
    [single_board_controller.brd, single_board_controller.sch]
2019-06-01 pinout for raspberry pi
2019-06-01 Split write into its own thread, re-added toSend
2019-06-02 attiny85 Arduino code -- need to test
2019-06-02 implemented drill cycle
2019-06-02 fixed drill cycle
2019-06-03 added encoder test, really need to figure out stepper
2019-06-03 sort of got stepper working, got pump working
2019-06-03 implemented data file read, encoder, pump, and drill commands
2019-06-04 Verified shutdown logic, tabs replaced with spaces
    [APESShell.cpp]
2019-06-04 made pump an extension of Motor class
2019-06-04 fixed calls to deconstructors
    [APESShell.cpp]
2019-06-05 Altered stepper functions for constant dc/frequency
2019-06-05 Time function switcheroo
2019-06-05 adding params to fix compilation errors
    [APES.cpp, APES.h, APESShell.cpp, components.cpp, stepper_test.py]
2019-06-06 supposedly fixed stepper motor func, testing generally
    [stepper_test_up.py]
2019-06-06 added encoder/stepper test
