IGMercier/Autonomous-Prospecting-and-Extraction-Systems-Controls/(notices)

Notices in the files:
parts and their libraries:
con-jst-vh: Copyright (C) 2016, Bob Starr
SparkFun-Connectors: Licensing: Creative Commons ShareAlike 4.0 International - https://creativecommons.org/licenses/by-sa/4.0
Wurth_Elektronik_Optoelectronics_rev18a: Copyright: Würth Elektronik
